NotCleo/TPU-Cores/host/out/input.png

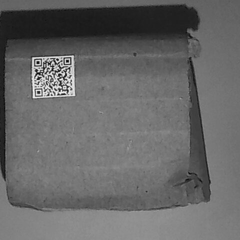
host/out/input.png
