NotCleo/TPU-Cores/vivado/build/sobel_tpu_soc.runs/impl_1/.init_design.begin.rst

<?xml version="1.0"?>
<ProcessHandle Version="1" Minor="0">
    <Process Command=".planAhead." Owner="amrut" Host="" Pid="234164">
    </Process>
</ProcessHandle>
