NotCleo/TPU-Cores/host/out/golden_float.png

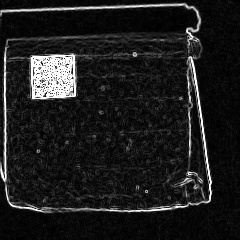
host/out/golden_float.png
