NotCleo/TPU-Cores/vivado/build/sobel_tpu_soc.runs/impl_1/clockInfo.txt

-------------------------------------
| Tool Version : Vivado v.2023.2
| Date         : Thu Jul  2 21:25:08 2026
| Host         : Maverick
| Design       : design_1
| Device       : xc7a100t-csg324-1--
-------------------------------------

For more information on clockInfo.txt clock routing debug file see https://support.xilinx.com/s/article/000035660?language=en_US
