NotCleo/TPU-Cores/vivado/build/sobel_tpu_soc.runs/system_bram_ctrl_0_synth_1/.vivado.begin.rst

<?xml version="1.0"?>
<ProcessHandle Version="1" Minor="0">
    <Process Command="vivado" Owner="amrut" Host="Maverick" Pid="230959" HostCore="16" HostMemory="15092008">
    </Process>
</ProcessHandle>
